knielsen/Ledcube/pcb.mess/ledcube11.sch

## KiCad design pcb.mess/ledcube11.sch (2012-04-08)

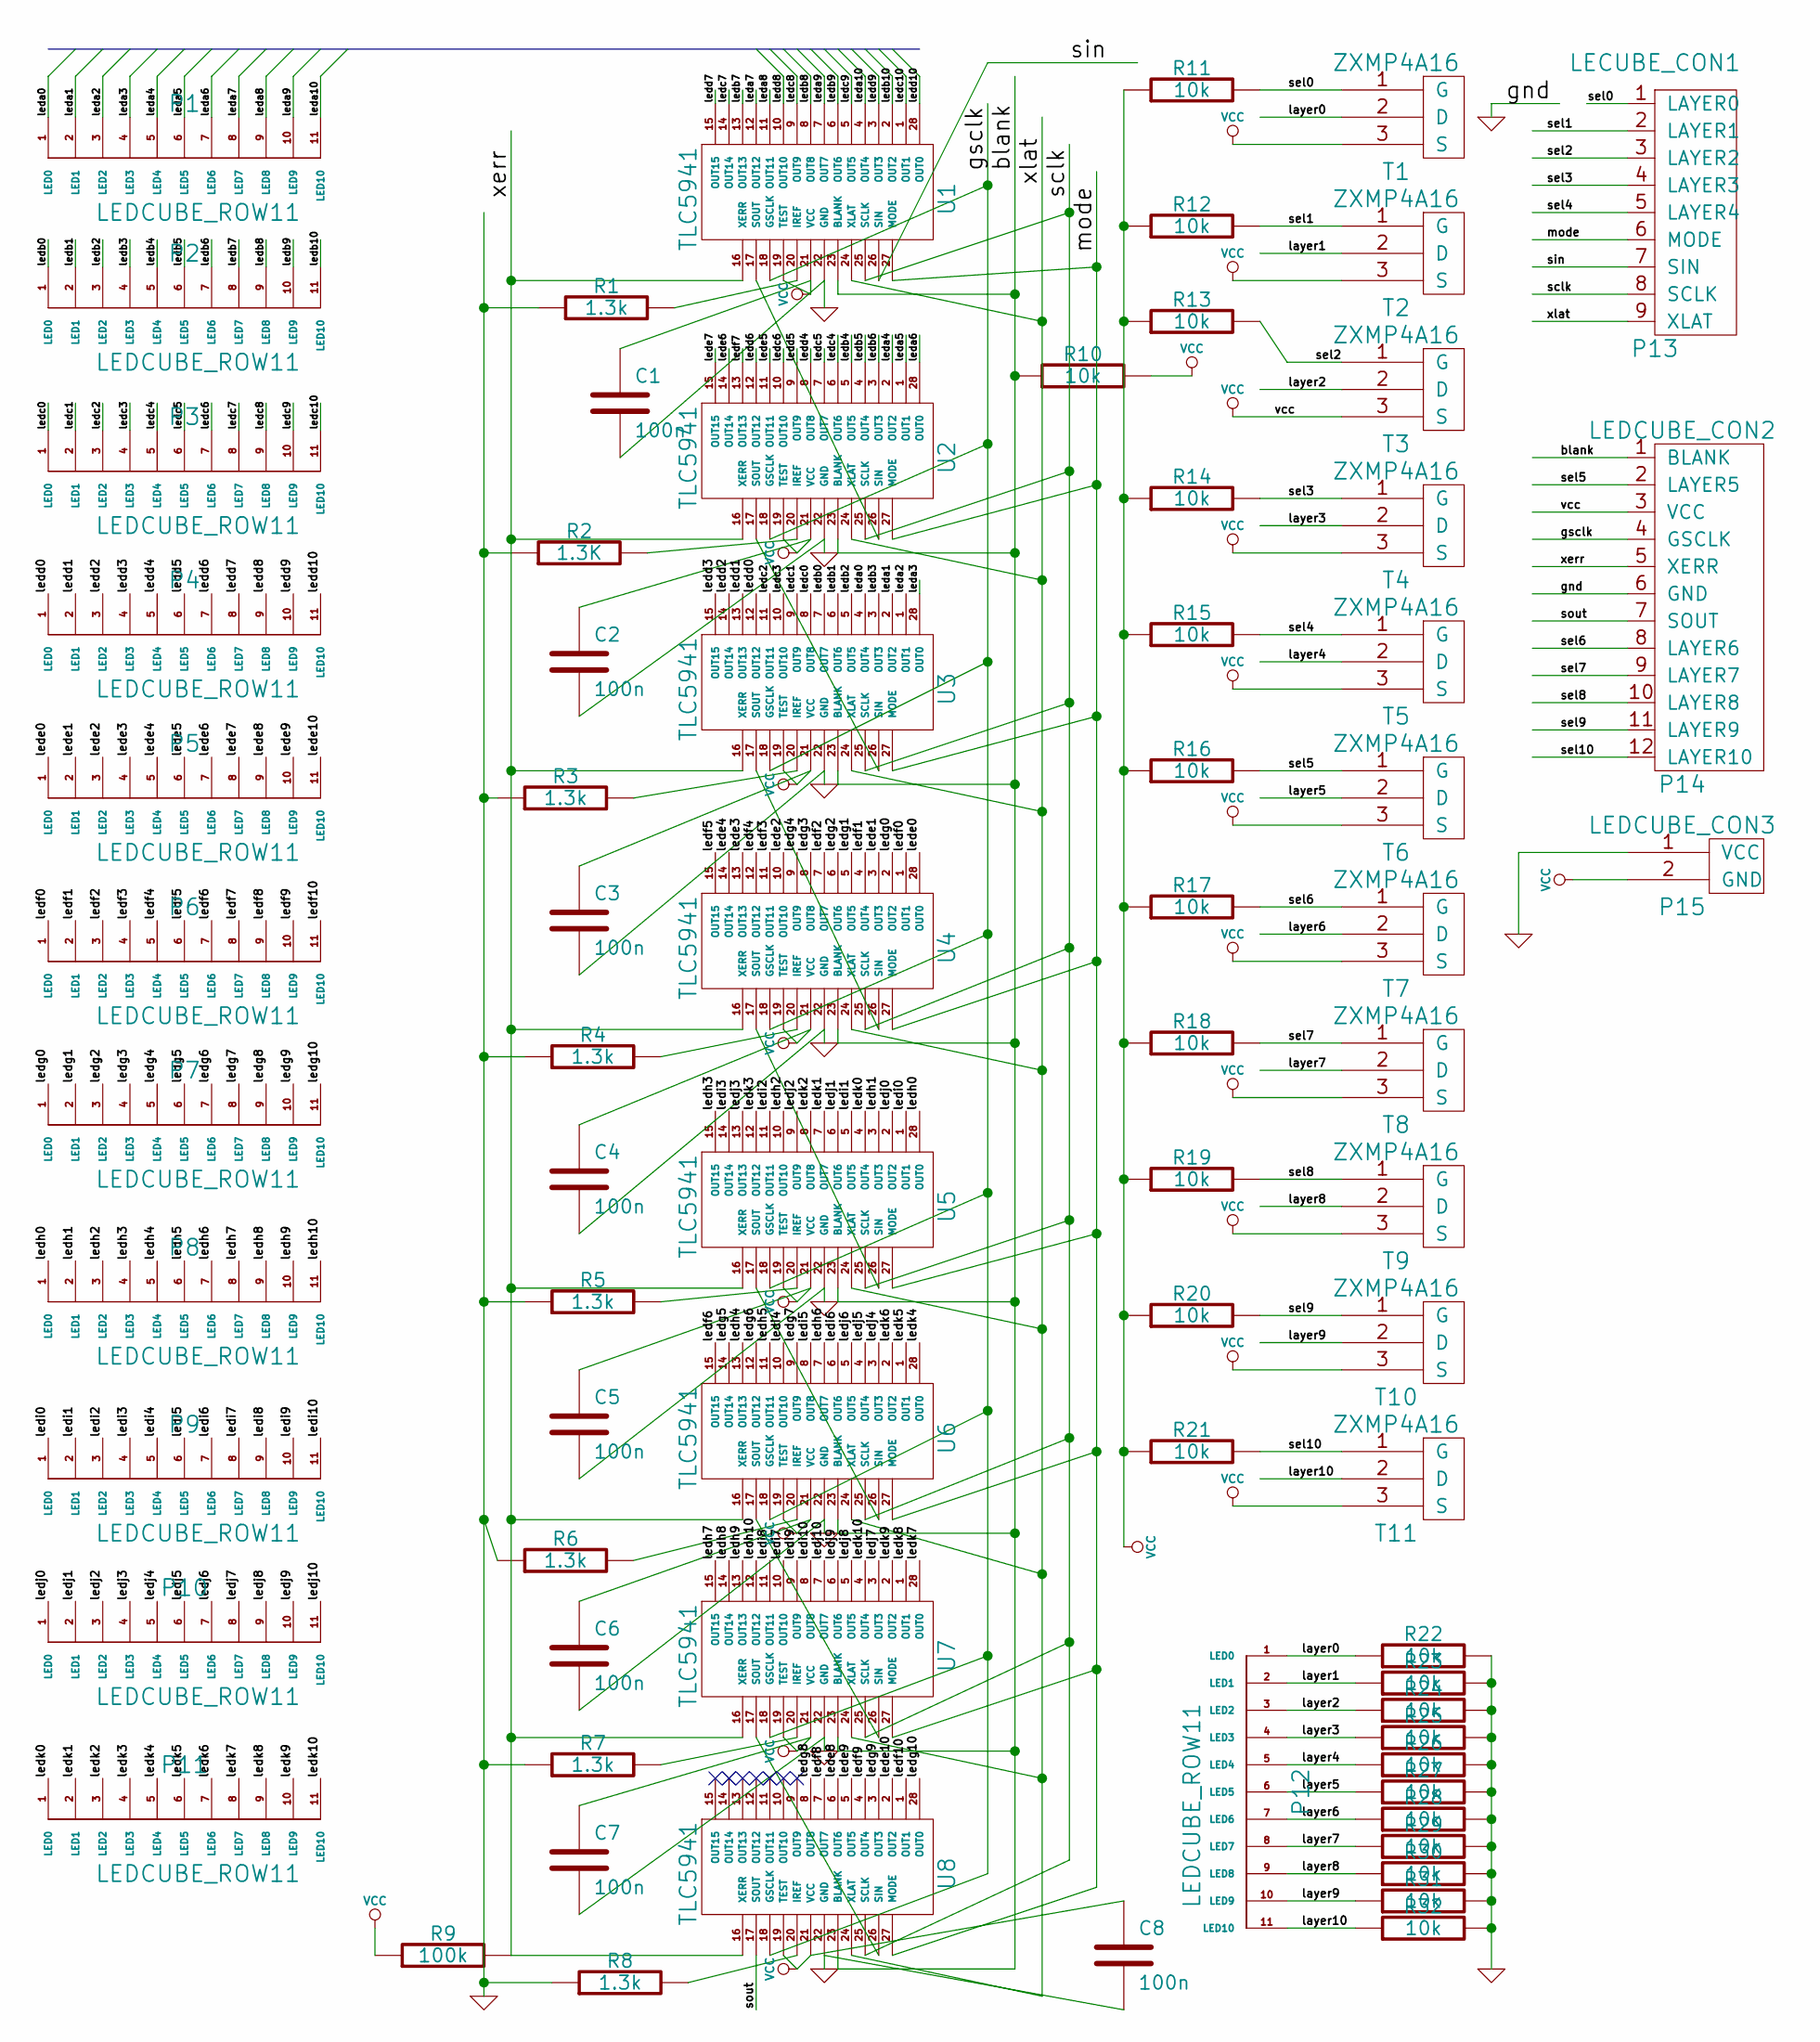
[picture p1: schematic ledcube11.sch]

Parts:
C1, C2, C3, C4, C5, C6, C7, C8: 100n
P1, P2, P3, P4, P5, P6, P7, P8, P9, P10, P11, P12: LEDCUBE_ROW11
P13: LECUBE_CON1
P14: LEDCUBE_CON2
P15: LEDCUBE_CON3
R1, R3, R4, R5, R6, R7, R8: 1.3k
R2: 1.3K
R9: 100k
R10, R11, R12, R13, R14, R15, R16, R17, R18, R19, R20, R21, R22, R23, R24, R25, R26, R27, R28, R29, R30, R31, R32: 10k
T1, T2, T3, T4, T5, T6, T7, T8, T9, T10, T11: ZXMP4A16
U1, U2, U3, U4, U5, U6, U7, U8: TLC5941

Connections:
unnamed: R1.2, U1.20 (IREF)
unnamed: R2.2, U2.20 (IREF)
unnamed: R3.2, U3.20 (IREF)
unnamed: R4.2, U4.20 (IREF)
unnamed: R5.2, U5.20 (IREF)
unnamed: R6.2, U6.20 (IREF)
unnamed: R7.2, U7.20 (IREF)
unnamed: R8.2, U8.20 (IREF)
unnamed: U1.17 (SOUT), U2.26 (SIN)
unnamed: U2.17 (SOUT), U3.26 (SIN)
unnamed: U3.17 (SOUT), U4.26 (SIN)
unnamed: U4.17 (SOUT), U5.26 (SIN)
unnamed: U5.17 (SOUT), U6.26 (SIN)
unnamed: U6.17 (SOUT), U7.26 (SIN)
unnamed: U7.17 (SOUT), U8.26 (SIN)
blank: P14.1 (BLANK), R10.1, U1.23 (BLANK), U2.23 (BLANK), U3.23 (BLANK), U4.23 (BLANK), U5.23 (BLANK), U6.23 (BLANK), U7.23 (BLANK), U8.23 (BLANK)
gnd: C1.2, C2.2, C3.2, C4.2, C5.2, C6.2, C7.2, C8.2, P14.6 (GND), P15.1 (VCC), R1.1, R2.1, R3.1, R4.1, R5.1, R6.1, R7.1, R8.1, R22.2, R23.2, R24.2, R25.2, R26.2, R27.2, R28.2, R29.2, R30.2, R31.2, R32.2, U1.22 (GND), U2.22 (GND), U3.22 (GND), U4.22 (GND), U5.22 (GND), U6.22 (GND), U7.22 (GND), U8.22 (GND)
gsclk: P14.4 (GSCLK), U1.18 (GSCLK), U2.18 (GSCLK), U3.18 (GSCLK), U4.18 (GSCLK), U5.18 (GSCLK), U6.18 (GSCLK), U7.18 (GSCLK), U8.18 (GSCLK)
layer0: P12.1 (LED0), R22.1, T1.2 (D)
layer1: P12.2 (LED1), R23.1, T2.2 (D)
layer2: P12.3 (LED2), R24.1, T3.2 (D)
layer3: P12.4 (LED3), R25.1, T4.2 (D)
layer4: P12.5 (LED4), R26.1, T5.2 (D)
layer5: P12.6 (LED5), R27.1, T6.2 (D)
layer6: P12.7 (LED6), R28.1, T7.2 (D)
layer7: P12.8 (LED7), R29.1, T8.2 (D)
layer8: P12.9 (LED8), R30.1, T9.2 (D)
layer9: P12.10 (LED9), R31.1, T10.2 (D)
layer10: P12.11 (LED10), R32.1, T11.2 (D)
leda0: P1.1 (LED0), U3.4 (OUT4)
leda1: P1.2 (LED1), U3.2 (OUT2)
leda2: P1.3 (LED2), U3.1 (OUT1)
leda3: P1.4 (LED3), U3.28 (OUT0)
leda4: P1.5 (LED4), U2.2 (OUT2)
leda5: P1.6 (LED5), U2.1 (OUT1)
leda6: P1.7 (LED6), U2.28 (OUT0)
leda7: P1.8 (LED7), U1.12 (OUT12)
leda8: P1.9 (LED8), U1.11 (OUT11)
leda9: P1.10 (LED9), U1.7 (OUT7)
leda10: P1.11 (LED10), U1.4 (OUT4)
ledb0: P2.1 (LED0), U3.7 (OUT7)
ledb1: P2.2 (LED1), U3.6 (OUT6)
ledb2: P2.3 (LED2), U3.5 (OUT5)
ledb3: P2.4 (LED3), U3.3 (OUT3)
ledb4: P2.5 (LED4), U2.5 (OUT5)
ledb5: P2.6 (LED5), U2.4 (OUT4)
ledb6: P2.7 (LED6), U2.3 (OUT3)
ledb7: P2.8 (LED7), U1.13 (OUT13)
ledb8: P2.9 (LED8), U1.8 (OUT8)
ledb9: P2.10 (LED9), U1.6 (OUT6)
ledb10: P2.11 (LED10), U1.2 (OUT2)
ledc0: P3.1 (LED0), U3.8 (OUT8)
ledc1: P3.2 (LED1), U3.9 (OUT9)
ledc2: P3.3 (LED2), U3.11 (OUT11)
ledc3: P3.4 (LED3), U3.10 (OUT10)
ledc4: P3.5 (LED4), U2.6 (OUT6)
ledc5: P3.6 (LED5), U2.7 (OUT7)
ledc6: P3.7 (LED6), U2.10 (OUT10)
ledc7: P3.8 (LED7), U1.14 (OUT14)
ledc8: P3.9 (LED8), U1.9 (OUT9)
ledc9: P3.10 (LED9), U1.5 (OUT5)
ledc10: P3.11 (LED10), U1.1 (OUT1)
ledd0: P4.1 (LED0), U3.12 (OUT12)
ledd1: P4.2 (LED1), U3.13 (OUT13)
ledd2: P4.3 (LED2), U3.14 (OUT14)
ledd3: P4.4 (LED3), U3.15 (OUT15)
ledd4: P4.5 (LED4), U2.8 (OUT8)
ledd5: P4.6 (LED5), U2.9 (OUT9)
ledd6: P4.7 (LED6), U2.12 (OUT12)
ledd7: P4.8 (LED7), U1.15 (OUT15)
ledd8: P4.9 (LED8), U1.10 (OUT10)
ledd9: P4.10 (LED9), U1.3 (OUT3)
ledd10: P4.11 (LED10), U1.28 (OUT0)
lede0: P5.1 (LED0), U4.28 (OUT0)
lede1: P5.2 (LED1), U4.3 (OUT3)
lede2: P5.3 (LED2), U4.10 (OUT10)
lede3: P5.4 (LED3), U4.13 (OUT13)
lede4: P5.5 (LED4), U4.14 (OUT14)
lede5: P5.6 (LED5), U2.11 (OUT11)
lede6: P5.7 (LED6), U2.14 (OUT14)
lede7: P5.8 (LED7), U2.15 (OUT15)
lede8: P5.9 (LED8), U8.6 (OUT6)
lede9: P5.10 (LED9), U8.5 (OUT5)
lede10: P5.11 (LED10), U8.2 (OUT2)
ledf0: P6.1 (LED0), U4.1 (OUT1)
ledf1: P6.2 (LED1), U4.4 (OUT4)
ledf2: P6.3 (LED2), U4.7 (OUT7)
ledf3: P6.4 (LED3), U4.11 (OUT11)
ledf4: P6.5 (LED4), U4.12 (OUT12)
ledf5: P6.6 (LED5), U4.15 (OUT15)
ledf6: P6.7 (LED6), U6.15 (OUT15)
ledf7: P6.8 (LED7), U2.13 (OUT13)
ledf8: P6.9 (LED8), U8.7 (OUT7)
ledf9: P6.10 (LED9), U8.4 (OUT4)
ledf10: P6.11 (LED10), U8.1 (OUT1)
ledg0: P7.1 (LED0), U4.2 (OUT2)
ledg1: P7.2 (LED1), U4.5 (OUT5)
ledg2: P7.3 (LED2), U4.6 (OUT6)
ledg3: P7.4 (LED3), U4.8 (OUT8)
ledg4: P7.5 (LED4), U4.9 (OUT9)
ledg5: P7.6 (LED5), U6.14 (OUT14)
ledg6: P7.7 (LED6), U6.12 (OUT12)
ledg7: P7.8 (LED7), U6.9 (OUT9)
ledg8: P7.9 (LED8), U8.8 (OUT8)
ledg9: P7.10 (LED9), U8.3 (OUT3)
ledg10: P7.11 (LED10), U8.28 (OUT0)
ledh0: P8.1 (LED0), U5.28 (OUT0)
ledh1: P8.2 (LED1), U5.3 (OUT3)
ledh2: P8.3 (LED2), U5.10 (OUT10)
ledh3: P8.4 (LED3), U5.15 (OUT15)
ledh4: P8.5 (LED4), U6.13 (OUT13)
ledh5: P8.6 (LED5), U6.11 (OUT11)
ledh6: P8.7 (LED6), U6.7 (OUT7)
ledh7: P8.8 (LED7), U7.15 (OUT15)
ledh8: P8.9 (LED8), U7.14 (OUT14)
ledh9: P8.10 (LED9), U7.13 (OUT13)
ledh10: P8.11 (LED10), U7.12 (OUT12)
ledi0: P9.1 (LED0), U5.1 (OUT1)
ledi1: P9.2 (LED1), U5.5 (OUT5)
ledi2: P9.3 (LED2), U5.11 (OUT11)
ledi3: P9.4 (LED3), U5.14 (OUT14)
ledi4: P9.5 (LED4), U6.10 (OUT10)
ledi5: P9.6 (LED5), U6.8 (OUT8)
ledi6: P9.7 (LED6), U6.6 (OUT6)
ledi7: P9.8 (LED7), U7.10 (OUT10)
ledi8: P9.9 (LED8), U7.11 (OUT11)
ledi9: P9.10 (LED9), U7.9 (OUT9)
ledi10: P9.11 (LED10), U7.8 (OUT8)
ledj0: P10.1 (LED0), U5.2 (OUT2)
ledj1: P10.2 (LED1), U5.6 (OUT6)
ledj2: P10.3 (LED2), U5.9 (OUT9)
ledj3: P10.4 (LED3), U5.13 (OUT13)
ledj4: P10.5 (LED4), U6.3 (OUT3)
ledj5: P10.6 (LED5), U6.4 (OUT4)
ledj6: P10.7 (LED6), U6.5 (OUT5)
ledj7: P10.8 (LED7), U7.3 (OUT3)
ledj8: P10.9 (LED8), U7.5 (OUT5)
ledj9: P10.10 (LED9), U7.6 (OUT6)
ledj10: P10.11 (LED10), U7.7 (OUT7)
ledk0: P11.1 (LED0), U5.4 (OUT4)
ledk1: P11.2 (LED1), U5.7 (OUT7)
ledk2: P11.3 (LED2), U5.8 (OUT8)
ledk3: P11.4 (LED3), U5.12 (OUT12)
ledk4: P11.5 (LED4), U6.28 (OUT0)
ledk5: P11.6 (LED5), U6.1 (OUT1)
ledk6: P11.7 (LED6), U6.2 (OUT2)
ledk7: P11.8 (LED7), U7.28 (OUT0)
ledk8: P11.9 (LED8), U7.1 (OUT1)
ledk9: P11.10 (LED9), U7.2 (OUT2)
ledk10: P11.11 (LED10), U7.4 (OUT4)
mode: P13.6 (MODE), U1.27 (MODE), U2.27 (MODE), U3.27 (MODE), U4.27 (MODE), U5.27 (MODE), U6.27 (MODE), U7.27 (MODE), U8.27 (MODE)
sclk: P13.8 (SCLK), U1.25 (SCLK), U2.25 (SCLK), U3.25 (SCLK), U4.25 (SCLK), U5.25 (SCLK), U6.25 (SCLK), U7.25 (SCLK), U8.25 (SCLK)
sel0: P13.1 (LAYER0), R11.2, T1.1 (G)
sel1: P13.2 (LAYER1), R12.2, T2.1 (G)
sel2: P13.3 (LAYER2), R13.2, T3.1 (G)
sel3: P13.4 (LAYER3), R14.2, T4.1 (G)
sel4: P13.5 (LAYER4), R15.2, T5.1 (G)
sel5: P14.2 (LAYER5), R16.2, T6.1 (G)
sel6: P14.8 (LAYER6), R17.2, T7.1 (G)
sel7: P14.9 (LAYER7), R18.2, T8.1 (G)
sel8: P14.10 (LAYER8), R19.2, T9.1 (G)
sel9: P14.11 (LAYER9), R20.2, T10.1 (G)
sel10: P14.12 (LAYER10), R21.2, T11.1 (G)
sin: P13.7 (SIN), U1.26 (SIN)
sout: P14.7 (SOUT), U8.17 (SOUT)
vcc: C1.1, C2.1, C3.1, C4.1, C5.1, C6.1, C7.1, C8.1, P14.3 (VCC), P15.2 (GND), R9.1, R10.2, R11.1, R12.1, R13.1, R14.1, R15.1, R16.1, R17.1, R18.1, R19.1, R20.1, R21.1, T1.3 (S), T2.3 (S), T3.3 (S), T4.3 (S), T5.3 (S), T6.3 (S), T7.3 (S), T8.3 (S), T9.3 (S), T10.3 (S), T11.3 (S), U1.19 (TEST), U1.21 (VCC), U2.19 (TEST), U2.21 (VCC), U3.19 (TEST), U3.21 (VCC), U4.19 (TEST), U4.21 (VCC), U5.19 (TEST), U5.21 (VCC), U6.19 (TEST), U6.21 (VCC), U7.19 (TEST), U7.21 (VCC), U8.19 (TEST), U8.21 (VCC)
xerr: P14.5 (XERR), R9.2, U1.16 (XERR), U2.16 (XERR), U3.16 (XERR), U4.16 (XERR), U5.16 (XERR), U6.16 (XERR), U7.16 (XERR), U8.16 (XERR)
xlat: P13.9 (XLAT), U1.24 (XLAT), U2.24 (XLAT), U3.24 (XLAT), U4.24 (XLAT), U5.24 (XLAT), U6.24 (XLAT), U7.24 (XLAT), U8.24 (XLAT)
