knielsen/Ledcube/(commit log)

2011-11-03 Initial commit. Basic LED control, but serial protocol unfinished.
2011-11-03 First version able to send frames to display from computer.
2011-11-03 Send back current frame from arduino.
2011-11-04 Emulate layer multiplexing by disabling BLANK for 10/11 of the time. Repeat frames while waiting for more serial data, to maximize refresh rate and minimize flicker. Fix checksum in test2.pl
    [ledcube.c]
2011-11-04 Fix it that we show the last complete frame, not the frame being downloaded.
    [ledcube.c]
2011-12-28 Add option --ledpro to produce output in "LedPRO" led-cube-protocol format.
2011-12-28 Fix copy-paste error in the cornercube animation.
    [mk_animation.cc]
2011-12-30 Add scrolltext animations and a couple of test images.
2012-01-05 Fix scroll text; it was mirror-imaged.
    [mk_animation.cc]
2012-01-26 New animation "icicles". Bugfix with signed char buffer overflow (ouch).
    [mk_animation.cc]
2012-02-02 Add a simple perl program to pipe animation data to the arduino, controlling the framerate.
2012-02-04 Adjust number of leds, so it's consistent between the various programs.
2012-02-04 Read and report status sent back from arduino.
2012-02-04 A new protocol supported --ledpro5, which shuffles around the LEDs a bit so that it fits the 5x5x5 cube wiring.
2012-02-04 Preliminary support for controlling MOSFETs (5x5x5).
2012-02-04 Couple more test images.
2012-02-05 Change to use a timer-based interrupt for shifting out each layer.
    This is needed to avoid flashing and wrong light level. Otherwise beat
    frequencies between the layer shifting and controller chip PWM frequencies
    cause flashing, as the beats vary with different serial interrupt loads.
    [ledcube.c]
2012-02-06 Re-code fast part of serial receive interrupt handler in hand-crafted assembler, to get a good speedup, leaving some breathing space for further development.
    Also fix silly missing-break-in-switch.
    [ledcube.c]
2012-02-06 Fix missing initialisation bug when --loop.
    [mk_animation.cc]
2012-02-06 Adjust for MOSFET wiring. The ledcube is playing animations now!
2012-02-06 A couple small tweaks following playing the animations on the real cube.
2012-02-06 Increase the framerate a bit, seems nicer.
2012-02-09 Modify pin13-status-led so I can measure CPU-usage for shift-out interrupt.
2012-02-11 Implement facility for on-board animation when no serial input.
    Main-loop follows shift-out and serial handlers.
    When serial goes idle, it start generating frames, in sync with frame
    shift-out.
    When serial is enabled again, it switches back to show what is received.
    As a bonus, we now auto-re-sync with serial when it has been idle for a bit.
    (skeleton on-board animation only for now)
2012-02-11 Now the Arduino plays the "cornercube" animation when it does not receive anything on the serial input.
2012-02-11 Oops, fix an overrun in fast_clear().
    [ledcube.c]
2012-02-12 The rotate_plane animation switches between different orientations.
2012-02-18 New animation: 3D game-of-life.
    Also nice afterglow on rotateplane animation, plus more lively (and thus
    better-looking) wobblyplabe animation.
    [mk_animation.cc]
2012-02-25 Adjust framerate to 50 Hz (from 35), to get things to look more lively.
2012-03-08 Adjust for the final wiring of the 11x11x11 cube.
2012-03-09 Let Arduino verify the checksum and skip+complain about error frames.
    [ledcube.c]
2012-03-09 Small adjustments to couple animations.
2012-03-11 Separate ledcube5.c for 5x5x5.
2012-03-11 Fix to better parametired on animation type, to prepare for more animations.
    [ledcube5.c]
2012-04-08 First version of PCB for 11x11x11 cube, made in Kicad.
    [ledcube11.brd, ledcube11.sch]
2012-04-11 Minor pcb adjustments to a resistor and more room to solder on power wires.
    [ledcube11.brd]
2012-04-13 Move the pins to supply power to each layer inside the cube.
    This way, the vertical supply wires going to each layer will be less visible.
    [ledcube11.brd]
2012-04-14 Hack to fix column 40 - moved to a good output on another chip.
    [ledcube.c]
2012-04-14 Introduce a mapping table that maps each LED to the index in the frame.
    This table is stored in program flash. It allows to more easily map
    out the bad outputs and redirect the affected LEDs to another output.
    4 LEDs are not remapped like this away from broken chip 2.
    [ledcube.c]
2012-04-30 Fixes from SiGNOUT for font9 and two more patched tlc5947 outputs.
    [ledcube.c, mk_animation.cc]
